AlexGyver/GyverMOD/README.md

# Вейп БоксМод GyverMOD

## Папки

**GyverMOD_libs** - папка с файлами библиотек, установить в C:\Program Files\Arduino\libraries
  
**GyverMOD_v._1.0.*_DISP** - прошивка для Ардуино, актуальная версия с варивольтом

**GyverMOD_v._1.2.*_DISP** - прошивка для Ардуино, актуальная версия с варивольтом и ручным вариваттом

**images** - рендеры 3D модели, компоновка

**ВНИМАНИЕ! ПУТЬ К ПАПКЕ СО СКЕТЧЕМ НЕ ДОЛЖЕН СОДЕРЖАТЬ РУССКИХ СИМВОЛОВ!
ВО ИЗБЕЖАНИЕ ПРОБЛЕМ ПОЛОЖИТЕ ПАПКУ В КОРЕНЬ ДИСКА С.**

### Схема подключения, версия 1.0
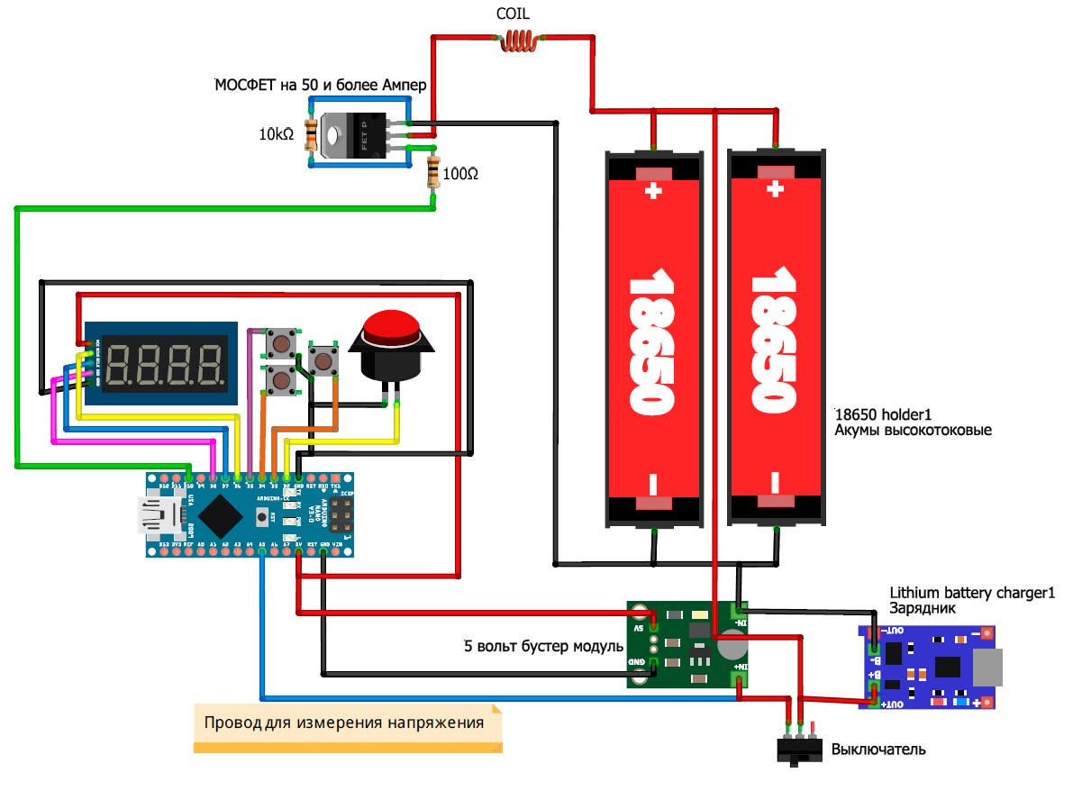
[picture p1: scheme_1.0.jpg]


### Компоновка, версия 1.0
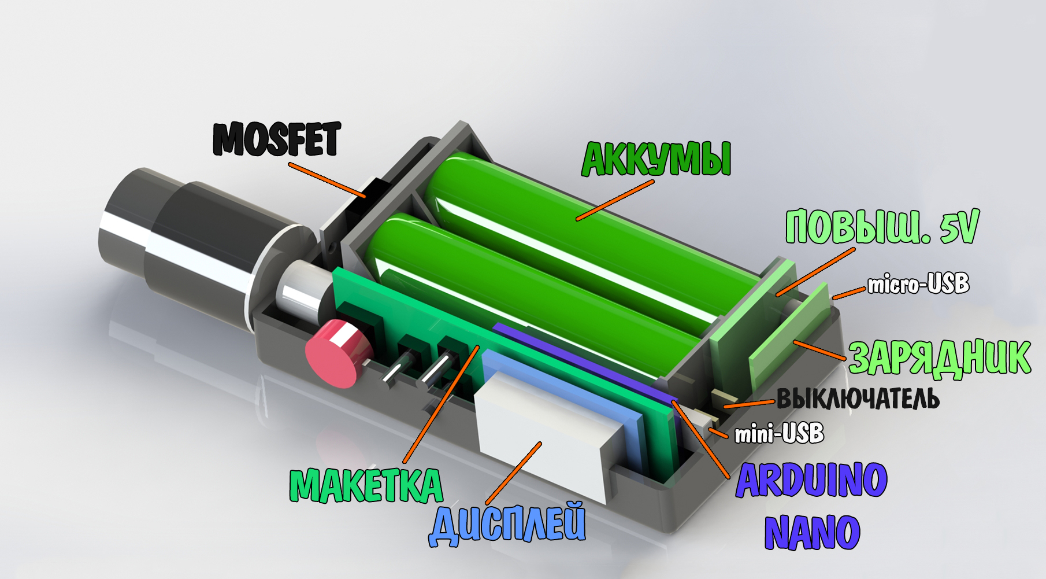
[picture p2: images/GM 1.0/comp1.jpg]


### Схема подключения, версия 1.2
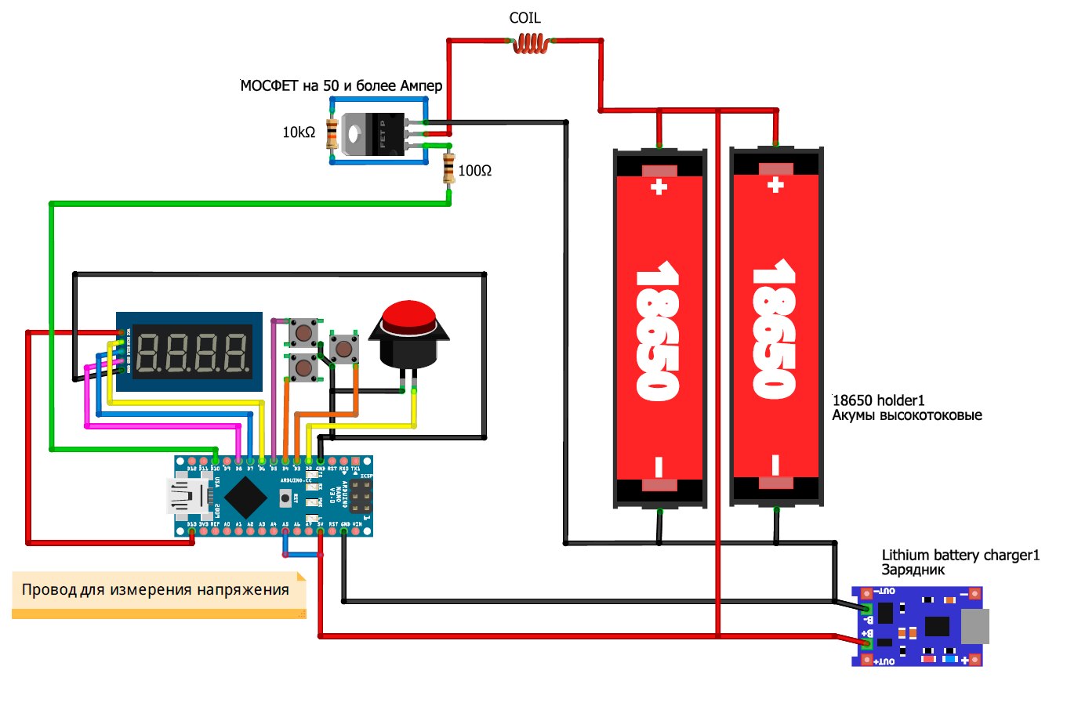
[picture p3: scheme_1.2.jpg]


### Компоновка, версия 1.2
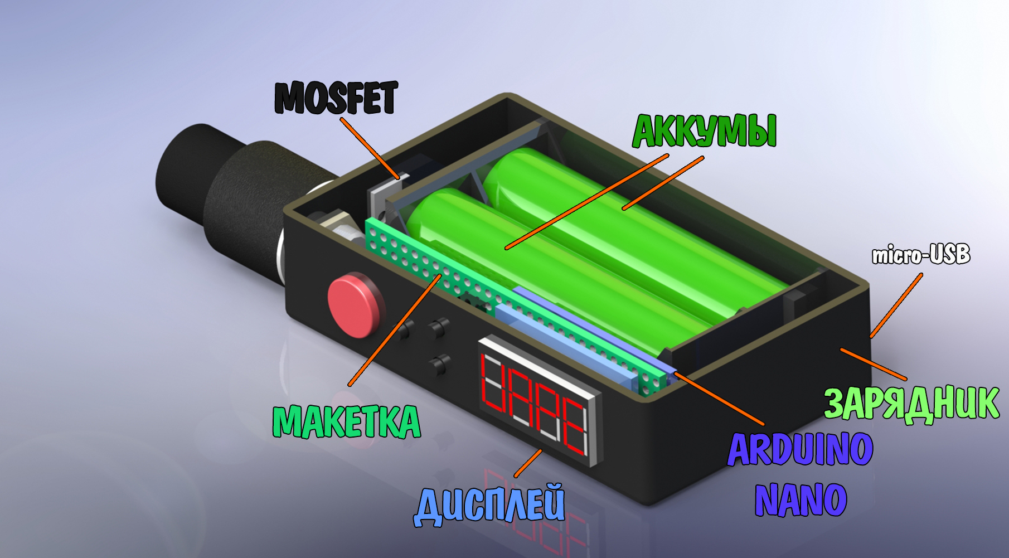
[picture p4: images/GM 1.2/comp3.jpg]


## Нужная инфа
### Страница проекта на моём сайте
http://AlexGyver.ru/gyvermod/

### Настройки в прошивке (1 - вкл, 0 - выкл): 
* initial_calibration - калибровка вольтметра 1 - включить, 0 - выключить
* welcome - приветствие (слова GYVER VAPE при включении), 1 - включить, 0 - выключить
* battery_info - отображение напряжения аккумулятора при запуске, 1 - включить, 0 - выключить
* sleep_timer - таймер сна в секундах
* vape_threshold - отсечка затяжки, в секундах
* turbo_mode - турбо режим 1 - включить, 0 - выключить
* battery_percent - отображать заряд в процентах, 1 - включить, 0 - выключить
* battery_low - нижний порог срабатывания защиты от переразрядки аккумулятора, в Вольтах!

###Статья первые шаги с Arduino
► http://alexgyver.ru/arduino-first/

##  Материалы и компоненты
Почти всё указанное ниже можно найти здесь:
- Страница с вейпами http://alexgyver.ru/vapes/
- Ардуино и электроника http://alexgyver.ru/arduino_shop/

* Корпус https://ali.ski/d9zYwX https://ali.ski/KGMWOB
* Макетка https://ali.ski/MooYRL
* Дисплей https://ali.ski/GFfuDU
* Кнопки длинные
* 50 шт. https://ali.ski/IcDhq0
* 1 шт. https://www.chipdip.ru/product/tyco-2-1825910-7-fsm14jh
* Кнопка большая
* 20 шт. https://ali.ski/wmg-Y
* 1 шт. https://www.chipdip.ru/product/tyco-1437565-5-fsm103
* колпачок https://www.chipdip.ru/product/swt-9r-r
* Стильная кнопка https://ali.ski/bplVow
* https://www.chipdip.ru/product/pbs26c
* Arduino NANO 328p – искать
* https://ali.ski/WtHJkn
* https://ali.ski/ExsaD
* https://ali.ski/t027q
* https://ali.ski/iFoCj
* Giant4 (Россия)
* Холдер х2 https://ali.ski/DNvLlV
* Повыш. модуль https://ali.ski/mZquA7
* Зарядник https://ali.ski/8bsyr
* Выключатель
* 5 шт. https://ali.ski/miaT7r
* 1 шт. https://www.chipdip.ru/product/smrs-102-1c2
* Мосфеты
* 5 шт. Мощный https://ali.ski/1z4Td
* 1 шт. Мощный https://www.chipdip.ru/product/irlb3034pbf
* 1 шт. для омметра https://www.chipdip.ru/product/irlb8743pbf
* Резистор для омметра https://www.chipdip.ru/product0/510940674
* Резисторы 10 кОм
* Большой набор https://ali.ski/NAkzQ
* 1 шт. https://www.chipdip.ru/product0/41486
* Резисторы 100 Ом
* Большой набор https://ali.ski/NAkzQ
* 1 шт. https://www.chipdip.ru/product0/47324
* Провод толстый https://ali.ski/fmndX
* Акумы SONY VTС4 https://ali.ski/rLbZi
* Другие акумы https://alexgyver.ru/vapes/
* 510 коннектор https://ali.ski/u6grk
* Атомайзер https://ali.ski/gfHUV
* Другие атомайзеры https://alexgyver.ru/vapes/
* Кнопки, электроника, корпуса https://alexgyver.ru/electronics/
* Припой, паяльники https://alexgyver.ru/all-for-soldering/

•••••• ИТОГО ••••••
* 680 бокс
* 530 акумы
* 140 коннектор
* 300-500 дрипка

••••••••••••••••••
* 1800р готовый вейп
