AlexGyver/GyverMOD/images/GM 1.0/comp2.jpg

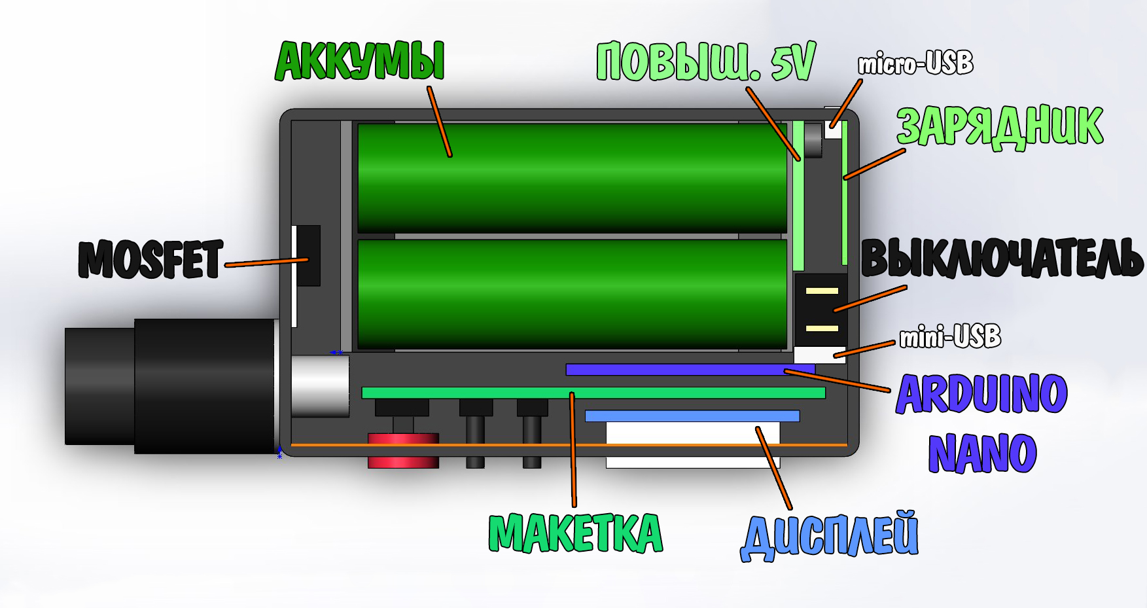
images/GM 1.0/comp2.jpg
