AlexGyver/GyverMOD/images/GM 1.0/GM1.0 (2).JPG

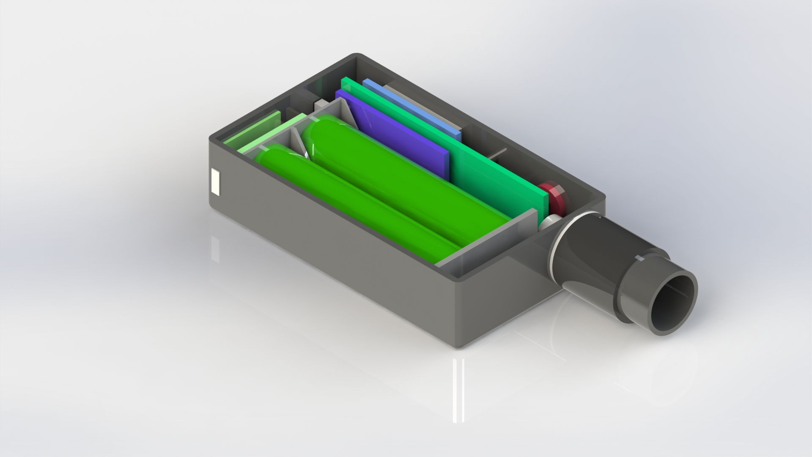
images/GM 1.0/GM1.0 (2).JPG
