AlexGyver/GyverMOD/images/GM 1.0/GM1.0 (3).JPG

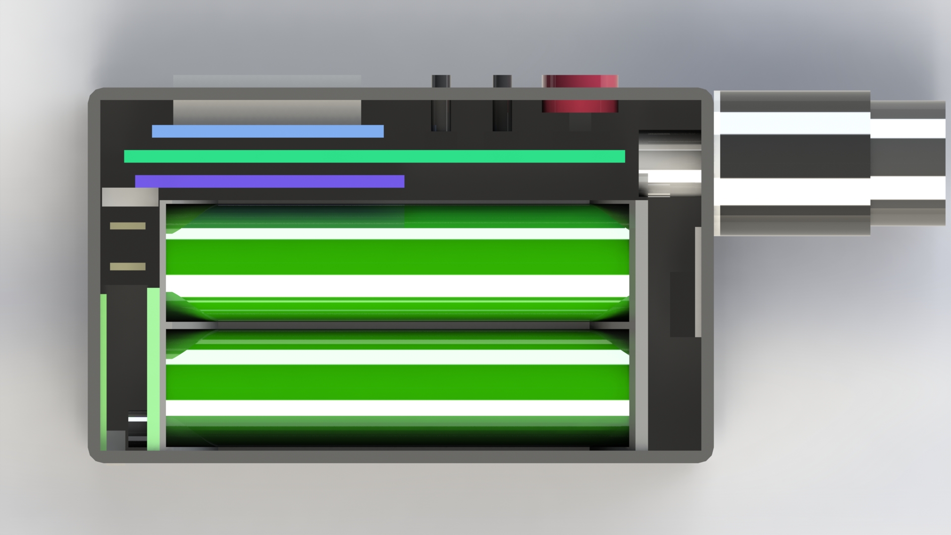
images/GM 1.0/GM1.0 (3).JPG
