AlexGyver/GyverMOD/images/GM 1.0/GM1.0 (4).JPG

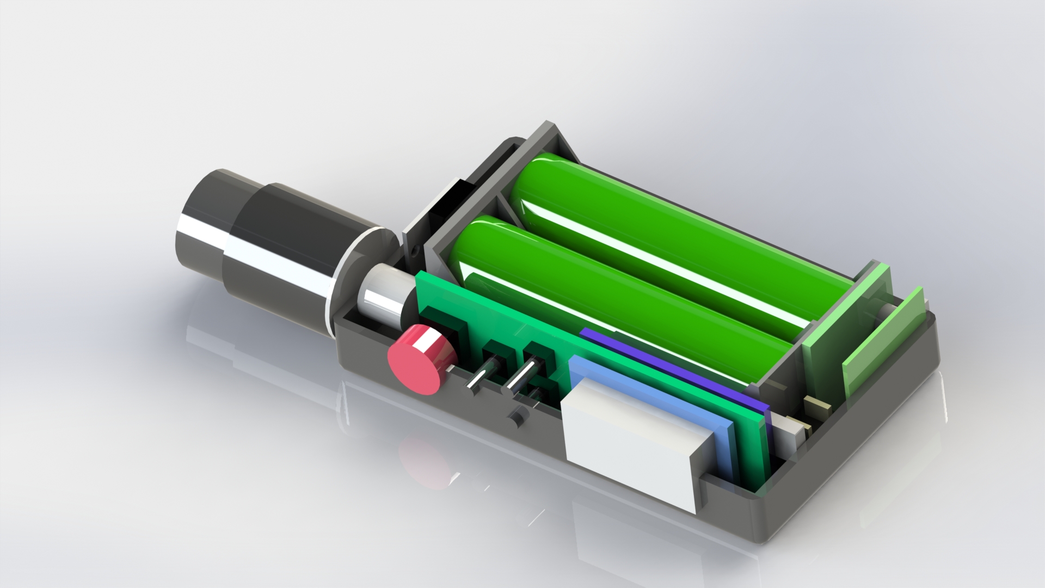
images/GM 1.0/GM1.0 (4).JPG
