AlexGyver/GyverMOD/images/GM 1.0/GM1.0 (5).jpg

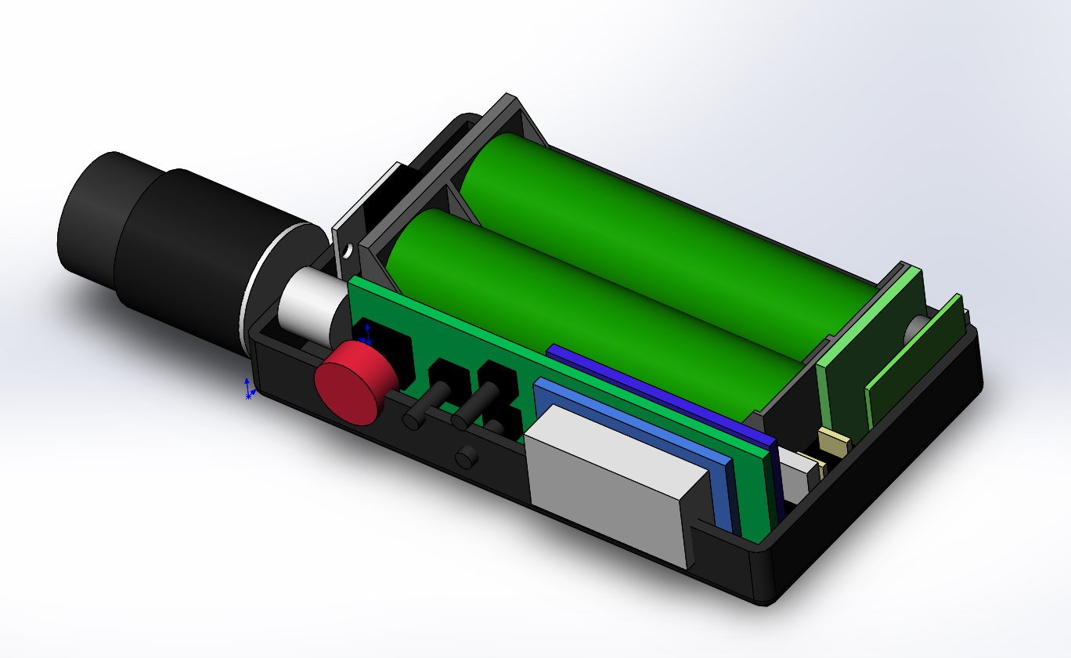
images/GM 1.0/GM1.0 (5).jpg
