AlexGyver/GyverMOD/images/GM 1.0/GM1.0 (6).jpg

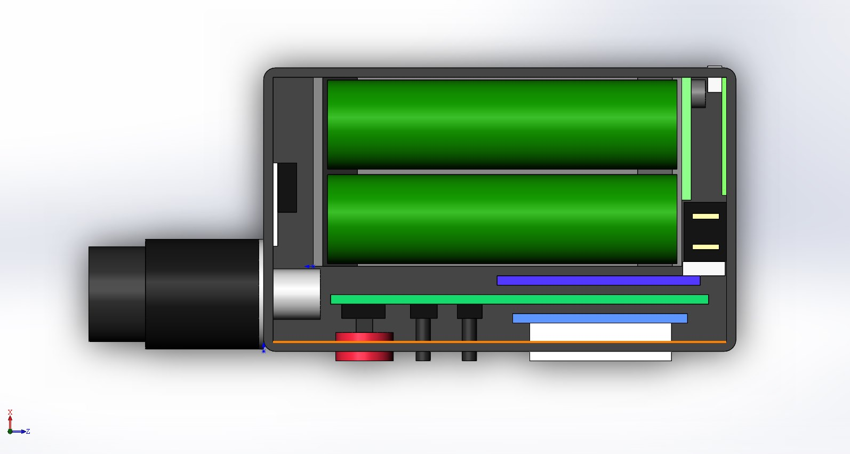
images/GM 1.0/GM1.0 (6).jpg
