AlexGyver/GyverMOD/images/GM 1.2/GM1.2 (3).JPG

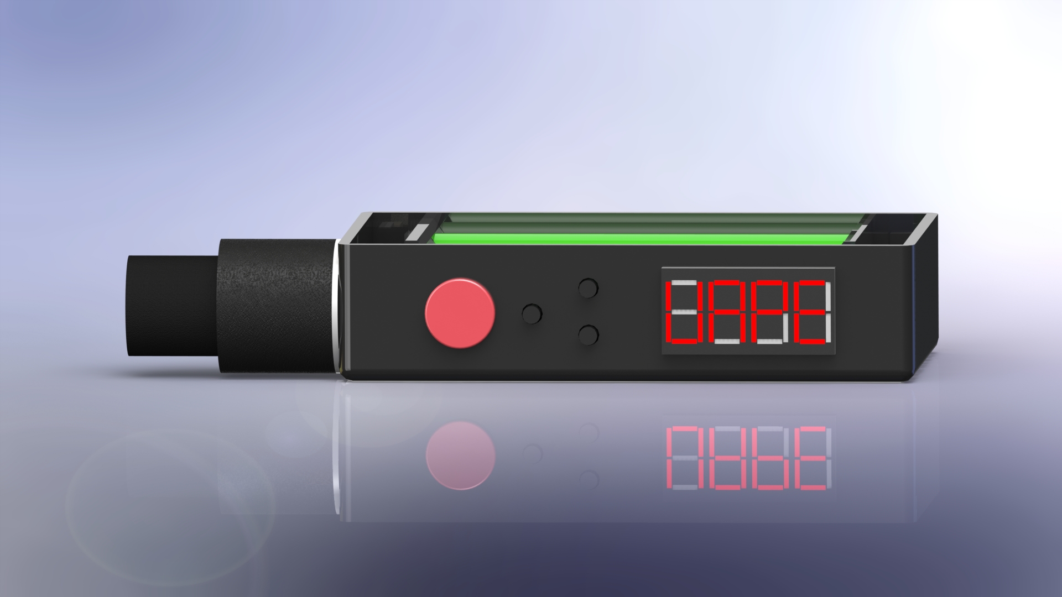
images/GM 1.2/GM1.2 (3).JPG
