AlexGyver/GyverMOD/(threads)

Thread 2 (2021-03-10):

Вопрос по коду.

maxim201977, 2021-03-10:
Добрый вечер, Alex Gaver. Я начел изучать ваш код и наткнулся на один момент, есть переменная PWM_f, которая при режиме варивольт расчитывается. А если установлен не этот режим, то переменнная PWM_f нигде не расчитывается. Как тогда это работает?

ruthenium-44, 2022-11-21:
Короче, переписал. Снизу подсчет ним через получение напряжения из мощности по U=sqrt(PR). Может оно и работало до этого, но так явно лучше.
```
                  if (mode == 1) {                                              // если ВАРИВАТТ
                        PWM = (float)sqrt(watts * ohms) / bat_volt_f * 1024;        // считаем значение для ШИМ сигнала
                        if (PWM > 1023) PWM = 1023;                                 // ограничил PWM "по-тупому", потому что constrain сука не работает!
                        PWM_f = PWM_filter_k * PWM + (1 - PWM_filter_k) * PWM_old;  // фильтруем
                        PWM_old = PWM_f;                                            // фильтруем
                    }
```
Если кто-то из админов воскреснет, закройте issue

Thread 3 (2022-10-15):

На дисплее горит 8--0

tigran73, 2022-10-15:
Подскажите что может быть. На дисплее горит 8--0. На кнопки не реагирует, а потом уходит в сон. Из сна просыпается 5 нажатиями. Корпуса пока нет, как и коннектора с атомайзером, но подсоединил вместо них спираль от HQD, мосфета такого же не нашел поставил IRF3205.

tigran73, 2022-10-15:
Дисплей 3461bs1-7.3

IlyaKangin, 2022-10-29:
пин для измерения акб подцепил?

tigran73, 2022-10-31:
Проблему решил неправильно сделал калиьровку

Closed 2022-10-31.

Thread 4 (2024-02-07):

Кто может помочь?

xXEgorproXx, 2024-02-07:
Кто сможет переделать с этой библиотеки дисплея на любую библиотеку на TM1637, тот дисплей который на видео у меня нигде не продается.

xXEgorproXx, 2024-02-07:
Извиняюсь, для всех вот ссылка https://yadi.sk/d/mu8XZ8eRf-b3FQ
источник https://community.alexgyver.ru/threads/vejp-boksmod-gyvermod.22/ (долистать вниз)

Closed 2025-01-09.
