AlexGyver/GyverMOD/(commit log)

2017-02-08 Добавлено
2017-02-10 Добавлены настройки
2017-02-10 обновлено
2017-02-12 обнговлено
2017-02-18 исправлено
2017-02-18 вава
2017-02-18 добавлена пиписька
2017-02-18 Увеличена точность измерения напряжения на аккумуляторах
2017-02-19 ИСПРАВЛЕНА ОШИБКА
2017-02-20 20.02.2017 Исправлена ошибочка
2017-02-20 ИСПРАВЛЕНА КРИТИЧЕСКАЯ ОШИБКА
2017-03-12 Улучшена стабильность
2017-08-06 исправлен баг
